LinBingKe/soil-water-content-monitor-system/README.md

# soil-water-content-monitor-system
Develop the system with independent power source that can measure water content of different soil depth and can sent the data to cloud platform.
