LinBingKe/soil-water-content-monitor-system/2020生機與農機學術研討會 林秉科.pdf

# 整合Watermark 200SS感測器和

# NB-IoT低功耗資料傳輸板 開發低成本土壤含水率智慧監控系統

## 林秉科、廖御瑋、申雍、陳建德、蔡燿全

## 國立中興大學 生物產業機電工程學系 國立中興大學 農藝學系 國立中興大學 土壤環境科學系

# 2020農機與生機學術研討會

目錄

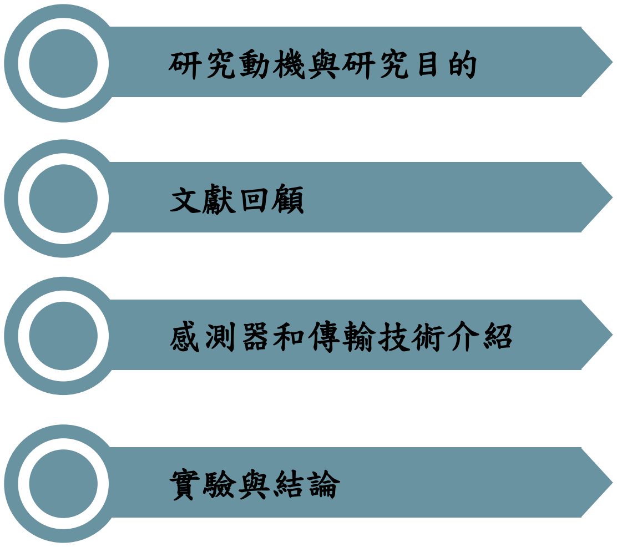
[picture p1: figure]
研究動機與研究目的; 文獻回顧; 感測器和傳輸技術介紹; 實驗與結論

# 研究動機與研究目的

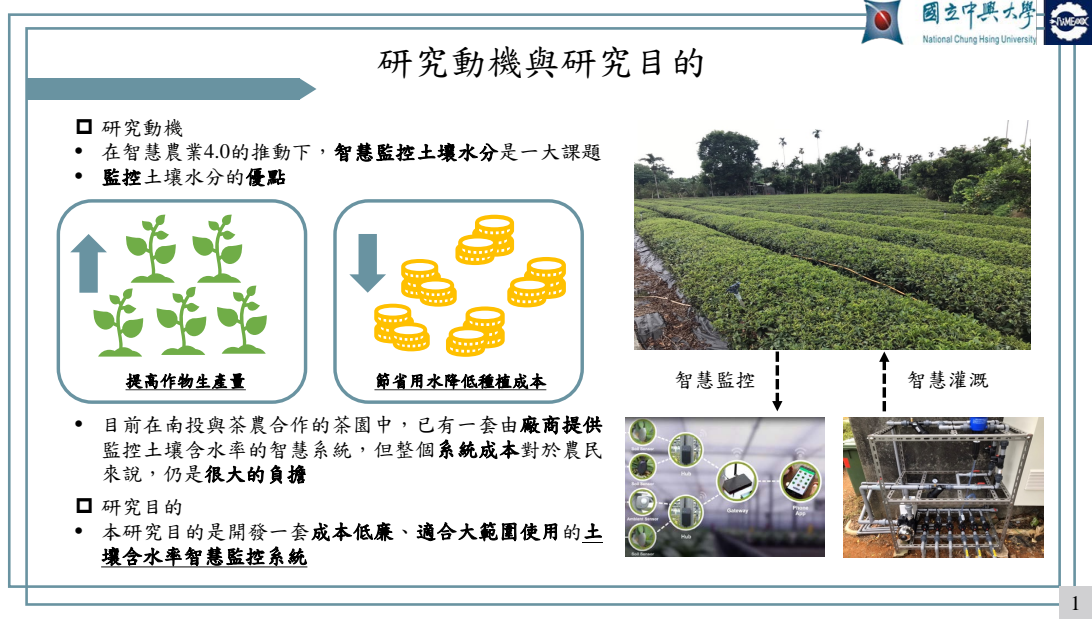
[picture p2: page 3]
研究動機 • 在智慧農業4.0的推動下，智慧監控土壤水分是一大課題 • 監控土壤水分的優點; • 目前在南投與茶農合作的茶園中，已有一套由廠商提供 監控土壤含水率的智慧系統，但整個系統成本對於農民 來說，仍是很大的負擔; 智慧監控; 智慧灌溉; 研究目的 • 本研究目的是開發一套成本低廉、適合大範圍使用的土 壤含水率智慧監控系統; 提高作物生產量; 節省用水降低種植成本

# 文獻回顧

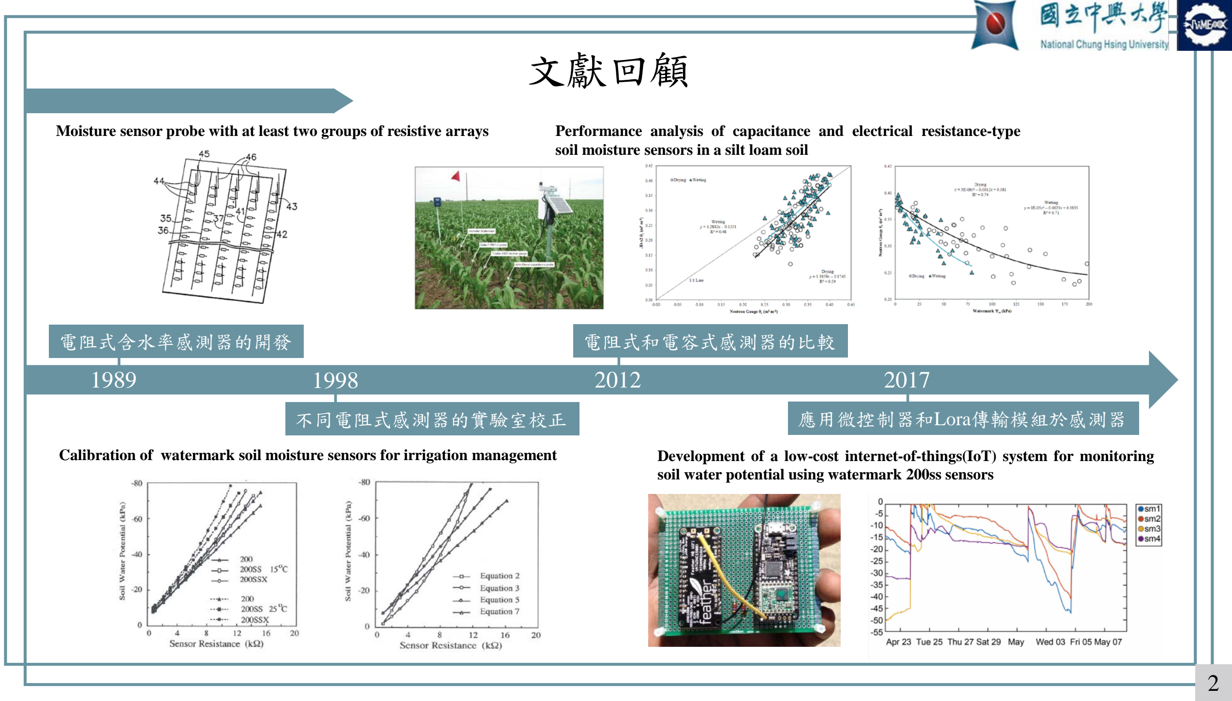
[picture p3: page 4]

1989 | 1998 | 2012 | 2017

Development of a low-cost internet-of-things(IoT) system for monitoring soil water potential using watermark 200ss sensors

Calibration of watermark soil moisture sensors for irrigation management

Moisture sensor probe with at least two groups of resistive arrays | Performance analysis of capacitance and electrical resistance-type soil moisture sensors in a silt loam soil

不同電阻式感測器的實驗室校正

電阻式和電容式感測器的比較

應用微控制器和Lora傳輸模組於感測器

電阻式含水率感測器的開發

含水率量測方式 | 環刀法 | 電阻式 | 電容式 | 水分張力計
量測 | 直接 | 間接 | 間接 | 間接
優點 | 數據準確 | 感測器成本低 | 準確度高 | 易於安裝

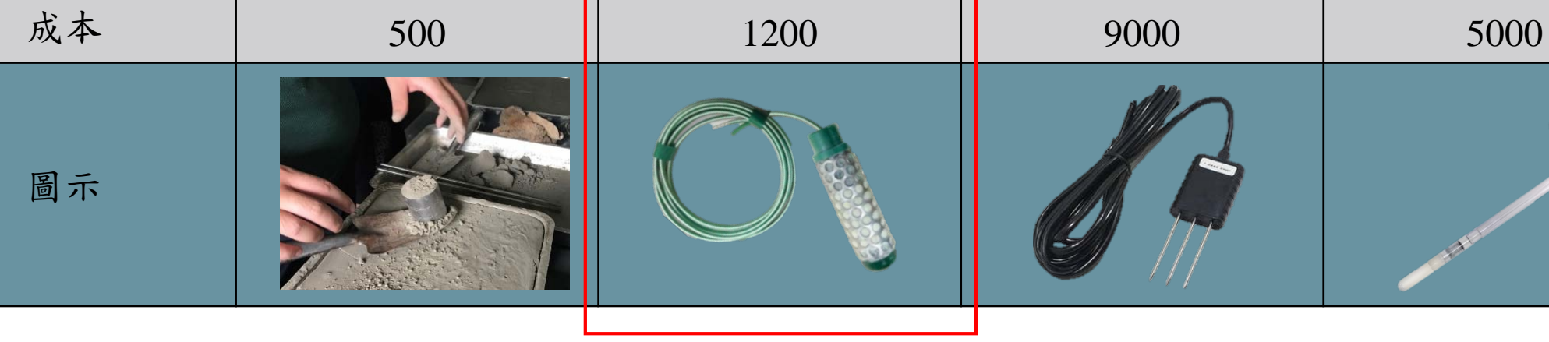
[picture p4: figure]
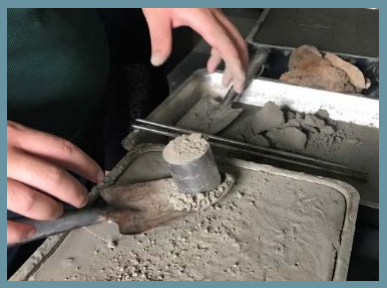
[picture p5: figure]
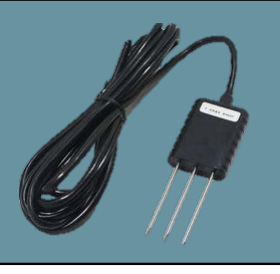
[picture p6: figure]
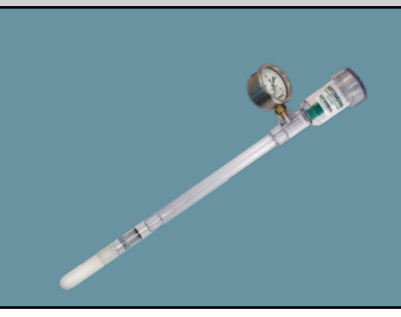
[picture p7: figure]

缺點 | • 不適合監控 • 花費時間長 • 無法重複量測 | • 需經過特定校正 • 平衡時間30分鐘 | • 昂貴 • 離子濃度影響量 測 | • 範圍有限 • 資料存取成本高 • 平衡時間30分鐘

# 土壤含水率量測介紹

## - Watermark 200SS感測器

# 土壤含水率感測器

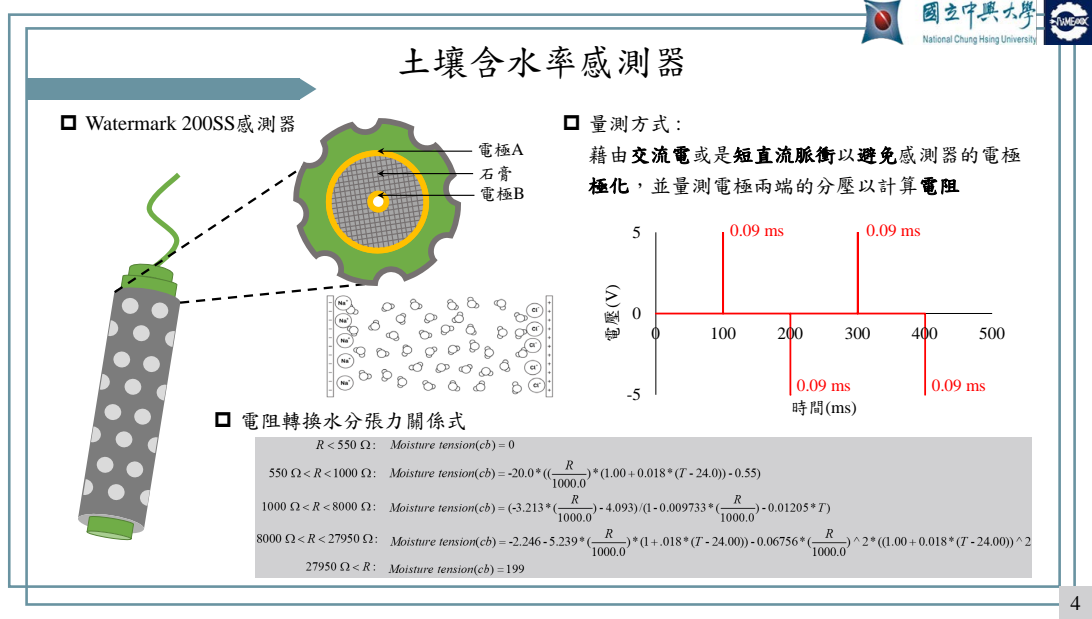
[picture p8: page 6]
量測方式 :; 藉由交流電或是短直流脈衝以避免感測器的電極; 電極B; 極化，並量測電極兩端的分壓以計算電阻 石膏; 電極A; 電阻轉換水分張力關係式

# 無線傳輸技術簡介

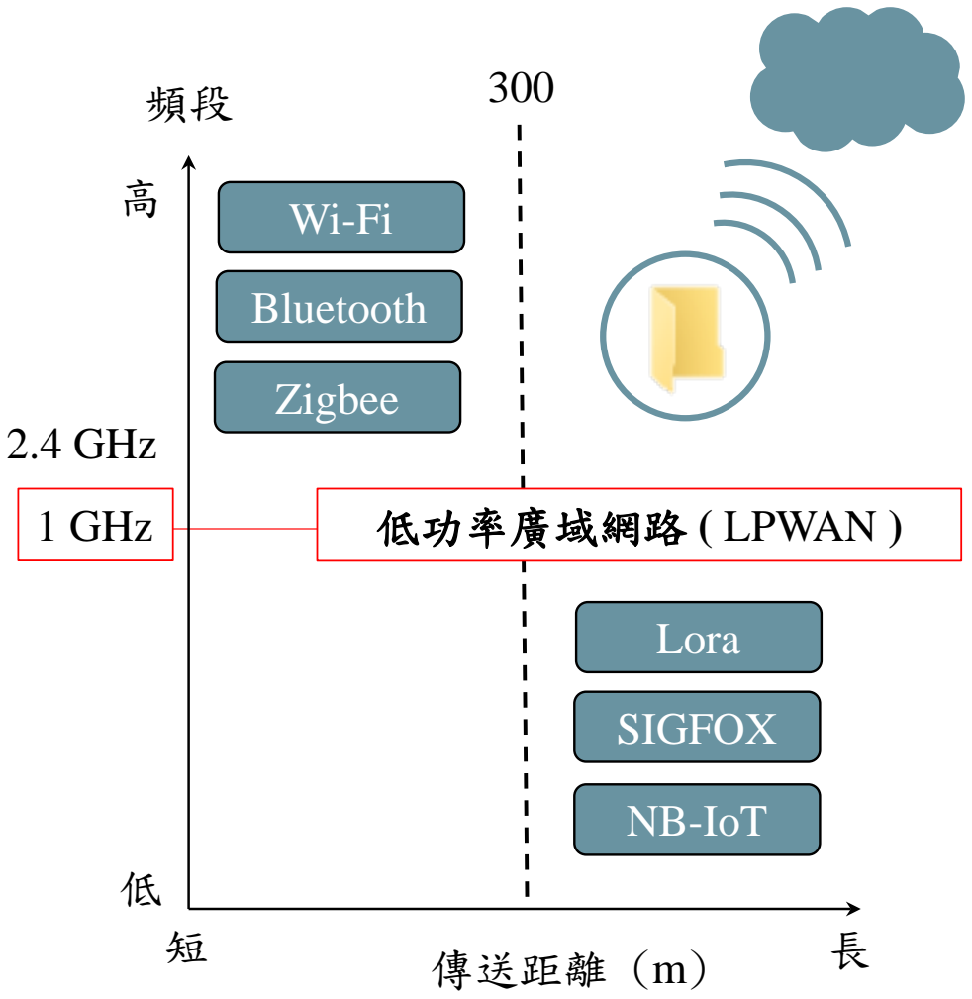
[picture p9: figure]
傳送距離 (m); Zigbee; Wi-Fi Bluetooth; SIGFOX; Lora; NB-IoT; 2.4 GHz; 1 GHz; 低功率廣域網路 ( LPWAN )

傳輸頻段 頻段 | 1 GHz以下 | 2.4 GHz以上
傳輸距離 | 長 | 短
受干擾程度 | 少 | 多
功耗 | 低 | 高
LPWAN | LoRa | SIGFOX | NB-IoT
授權頻段 | 非 | 非 | 是
頻寬 | 100 Hz | 125~500 kHz | 180 kHz
傳輸速率 | 100 bps | 300 bps~50 kbps | 50 kbps

# 土壤含水率監控系統

## NB-IoT開發版

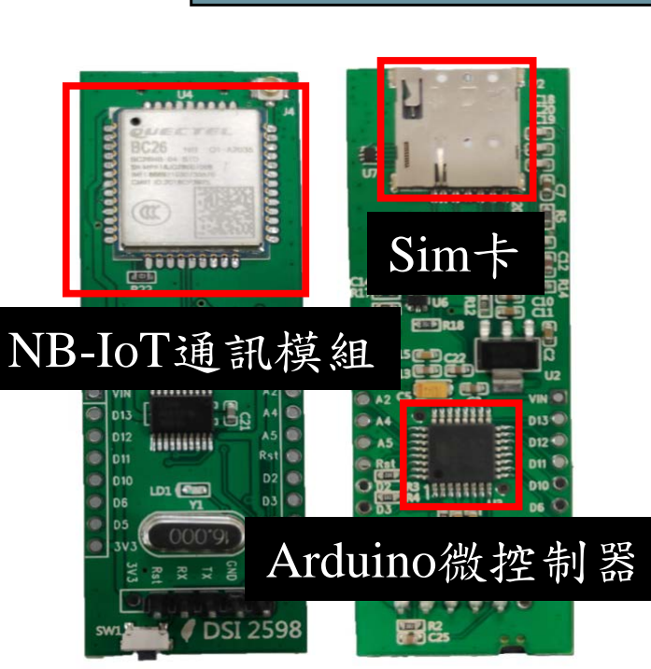
[picture p10: figure]
NB-IoT通訊模組; Arduino微控制器; Sim卡

Arduino微控制器 多路復用器

## NB-IoT通訊模組

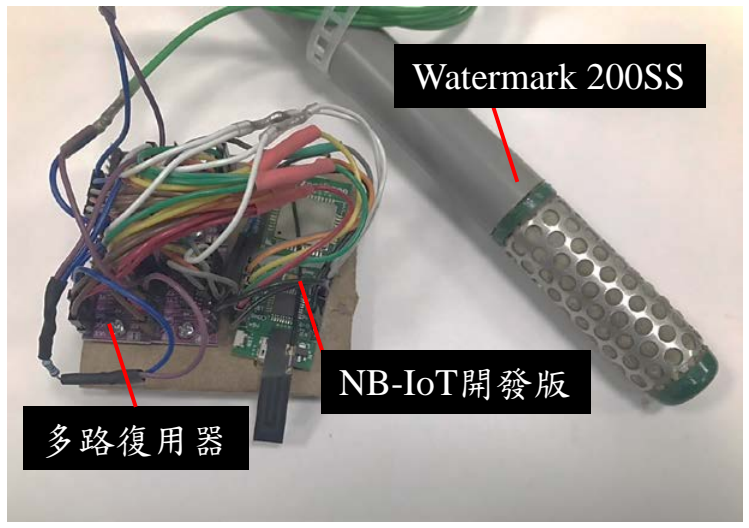
[picture p11: figure]
多路復用器; NB-IoT開發版; Watermark 200SS

土壤含水率感測器

| 上傳監控平台

量測數據

上傳數據

6.4 V磷酸鐵鋰電池

Vee | Y0
Gnd | Y1
Vcc | Y2
Z Y3
E Y4
S0 | Y5
S1 | Y6
S2 | Y7
電流閥門A | 電流閥門B

允許晶片作動

閥門B選擇

- 多路復用器
- 改變經過感測器的電流方向
- 增加監控連接感測器的數量
- 含水率監控系統架構圖

# 土壤含水率感測器校正

## Step. 3 安裝感測器

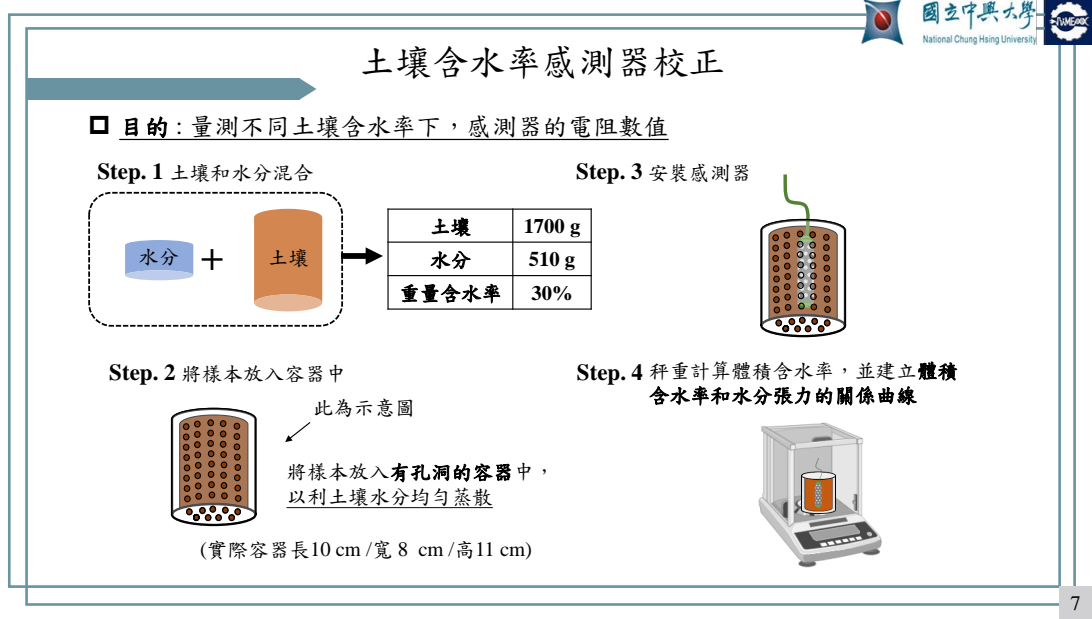
[picture p12: page 9]
Step. 1 土壤和水分混合; Step. 2 將樣本放入容器中; 將樣本放入有孔洞的容器中， 以利土壤水分均勻蒸散; 此為示意圖; 含水率和水分張力的關係曲線

目的 : 量測不同土壤含水率下，感測器的電阻數值

土壤 | 1700 g
水分 | 510 g
重量含水率 | 30%

Step. 4 秤重計算體積含水率，並建立體積

(實際容器長10 cm /寬 8 cm /高11 cm)

# 含水率感測器量測結果

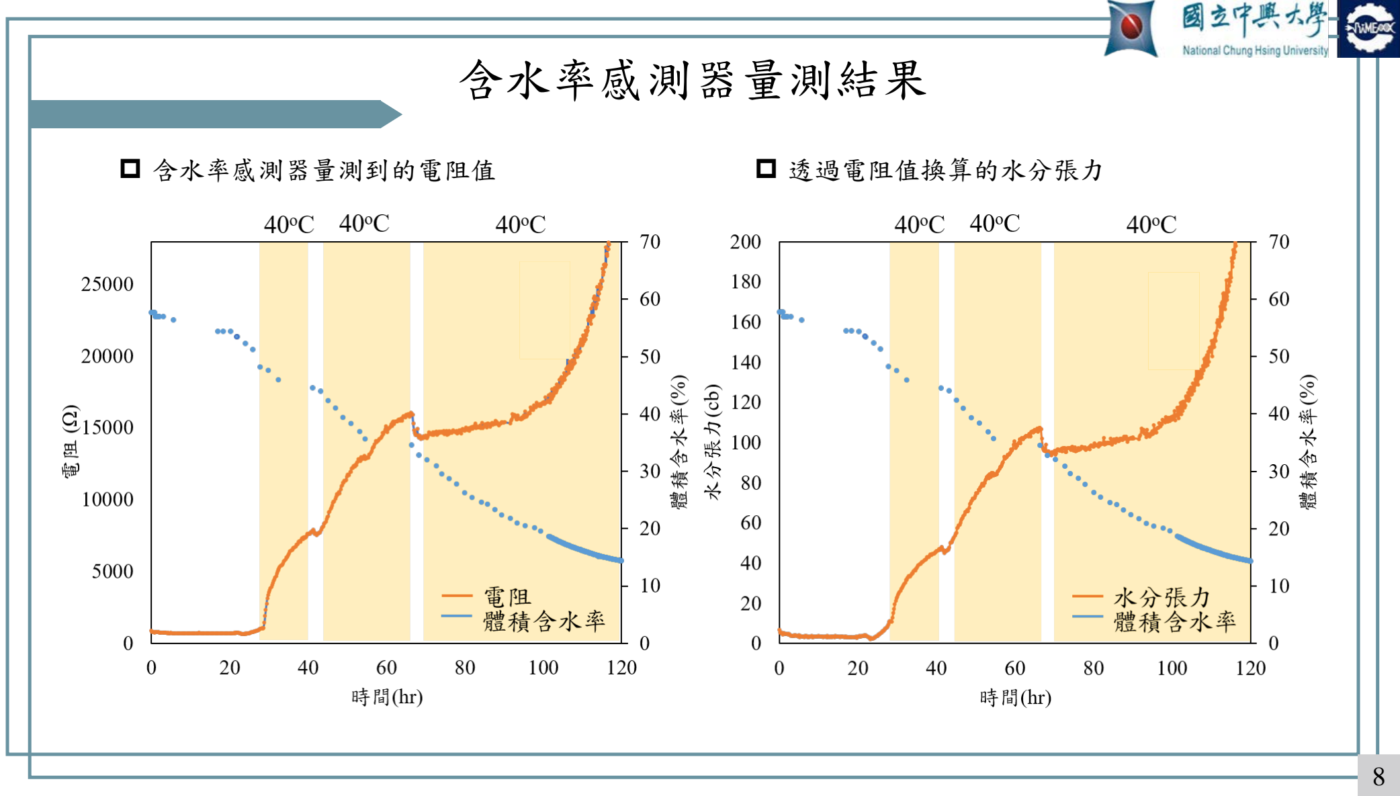
[picture p13: page 10]

- 含水率感測器量測到的電阻值 | 透過電阻值換算的水分張力

# 評估監控系統的耗電量

## 耗電量 (一天) : 0.723 Ah

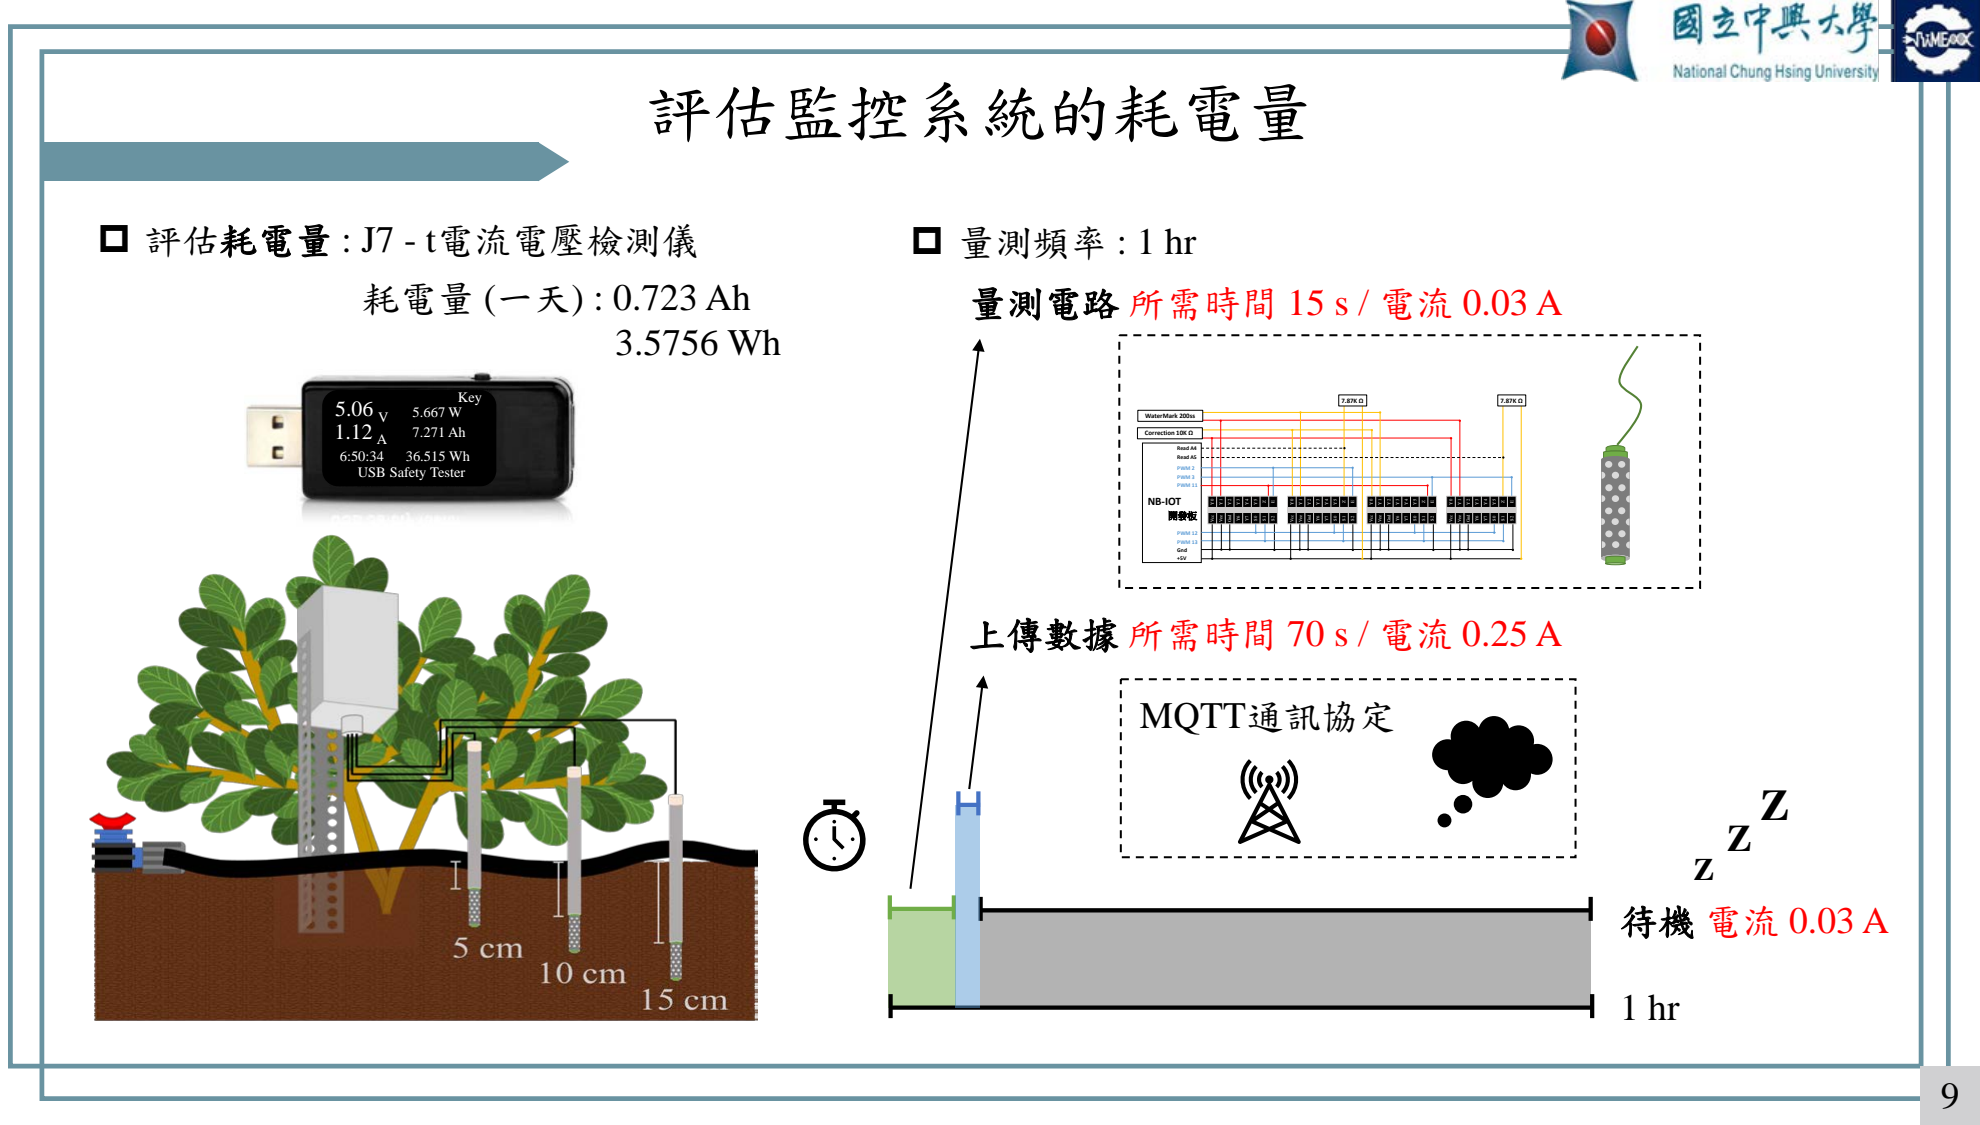
[picture p14: page 11]
USB Safety Tester; Key; 評估耗電量 : J7 - t電流電壓檢測儀; PWM 12 PWM 13; Gnd; Correction 10K Ω; WaterMark 200ss; PWM 3 PWM 11; PWM 2; Read A5; Read A4; NB-IOT; 開發板; Vcc; Vee; MQTT通訊協定

量測頻率 : 1 hr
量測電路 所需時間 15 s / 電流 0.03 A

上傳數據 所需時間 70 s / 電流 0.25 A

# 實地場域監控

## 5 cm 10 cm 15 cm

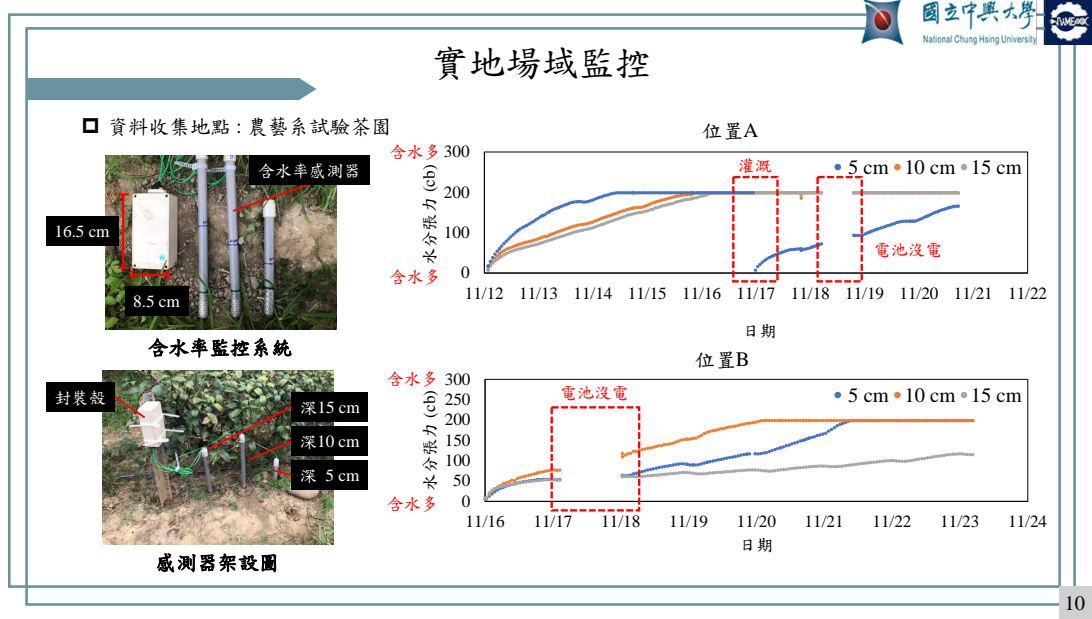
[picture p15: page 12]
資料收集地點 : 農藝系試驗茶園; 水分張力 (cb); 位置A; 含水率監控系統; 感測器架設圖; 封裝殼; 含水率感測器; 位置B; 電池沒電; 含水多

結論

### - 本研究成功整合Watermark 200SS感測器和NB-IoT資料傳輸系統，可於智慧平台

### 上進行含水率的監控 - 本研究的含水率監控系統的成本相較於市售含水率監控系統的花費來的便宜，適

### 合農民大範圍使用 - 未來將針對收集水分資訊進一步分析，並結合自動灌溉達到智慧化管理

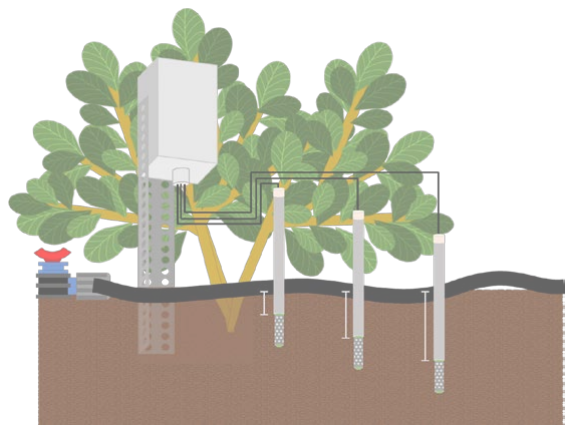
[picture p16: figure]
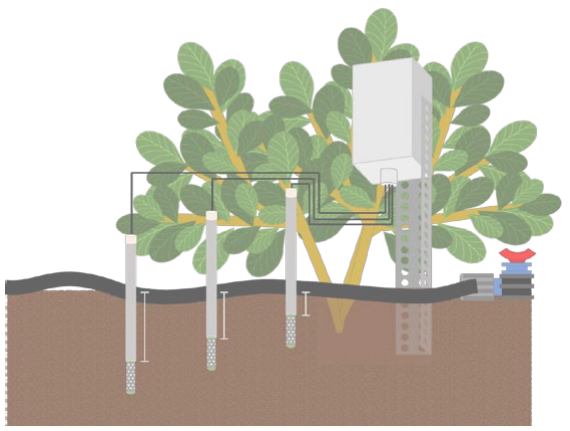
[picture p17: figure]

# Thank you for your attetion
