LinBingKe/soil-water-content-monitor-system/hardware.pdf

# 土壤含水率監控系統

# NB-IoT開發版

# Arduino微控制器 多路復用器

# NB-IoT通訊模組

# 土壤含水率感測器

| 上傳監控平台

# 量測數據

# 上傳數據

# 6.4 V磷酸鐵鋰電池

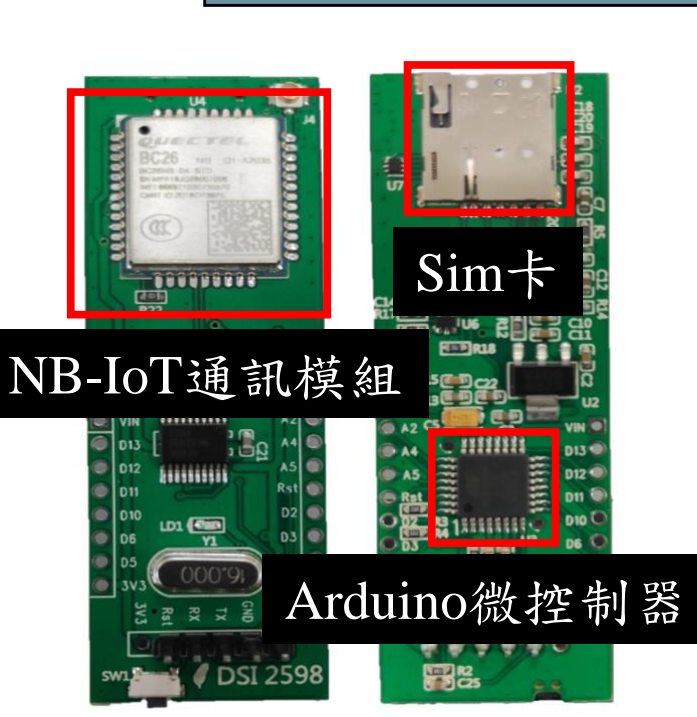
[picture p18: figure]
NB-IoT通訊模組; Arduino微控制器; Sim卡
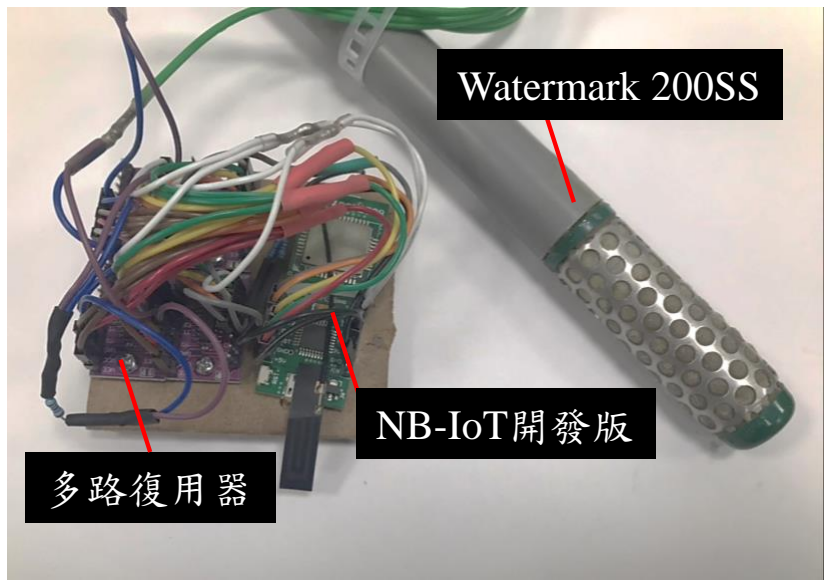
[picture p19: figure]
多路復用器; NB-IoT開發版; Watermark 200SS

Vee | Y0
Gnd | Y1
Vcc | Y2

Z Y3

E Y4

S0 | Y5
S1 | Y6
S2 | Y7
電流閥門A | 電流閥門B

# 允許晶片作動

# 閥門B選擇

# - 多路復用器 - 改變經過感測器的電流方向 - 增加監控連接感測器的數量

# - 含水率監控系統架構圖

# 土壤含水率監控系統

7.87K Ω | 7.87K Ω

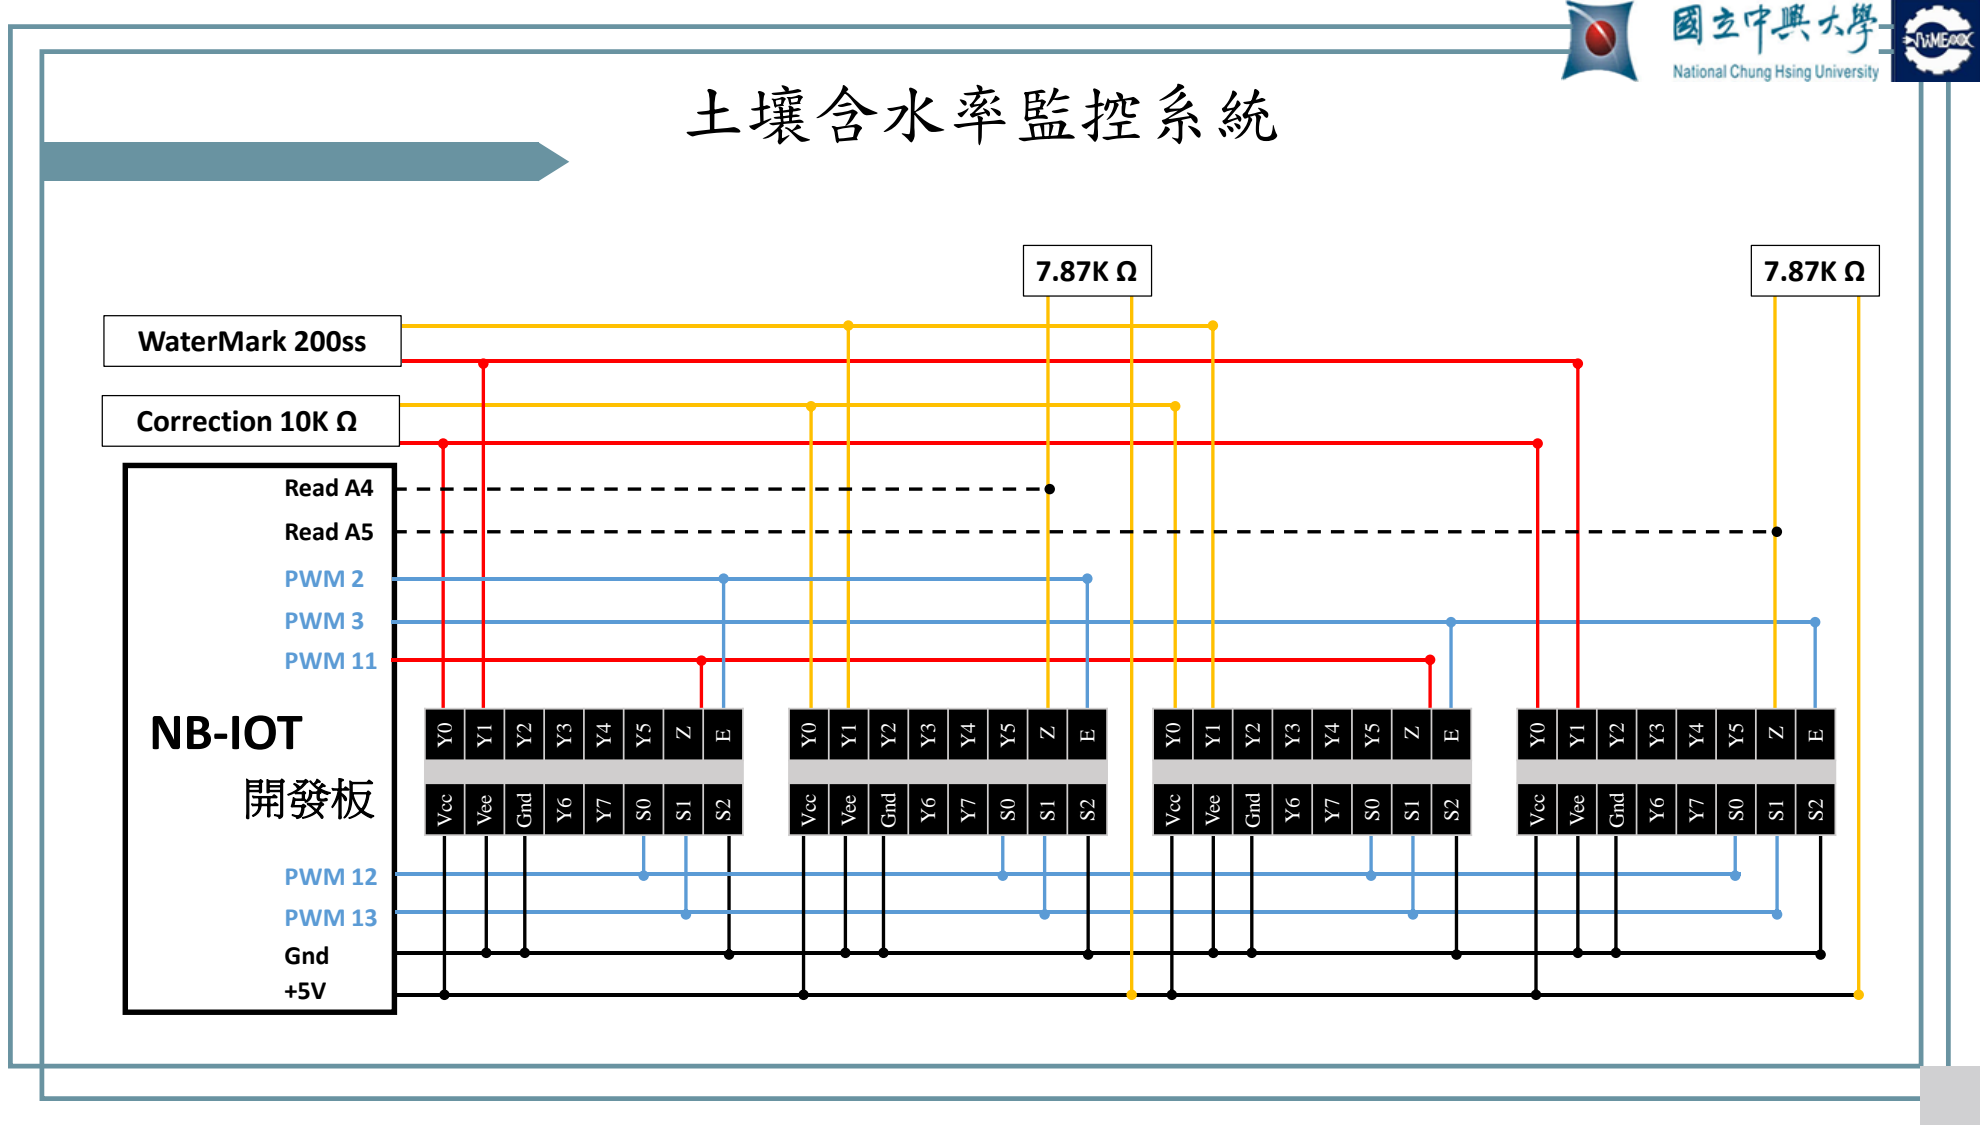
[picture p20: page 2]
PWM 12; PWM 13; Gnd; Correction 10K Ω; WaterMark 200ss; PWM 3; PWM 11; PWM 2; Read A5; Read A4; NB-IOT; 開發板

E Vcc Vee Gnd Y6 Y7 S0S1S2 Y0 Y1 Y2 Y3 Y4 Y5Z

E Vcc Vee Gnd Y6 Y7 S0S1S2
